POMBNK/DSpnp/ProgApp/ArduinoMega2560 Marlin update/система координат smd-раскладчика.jpg

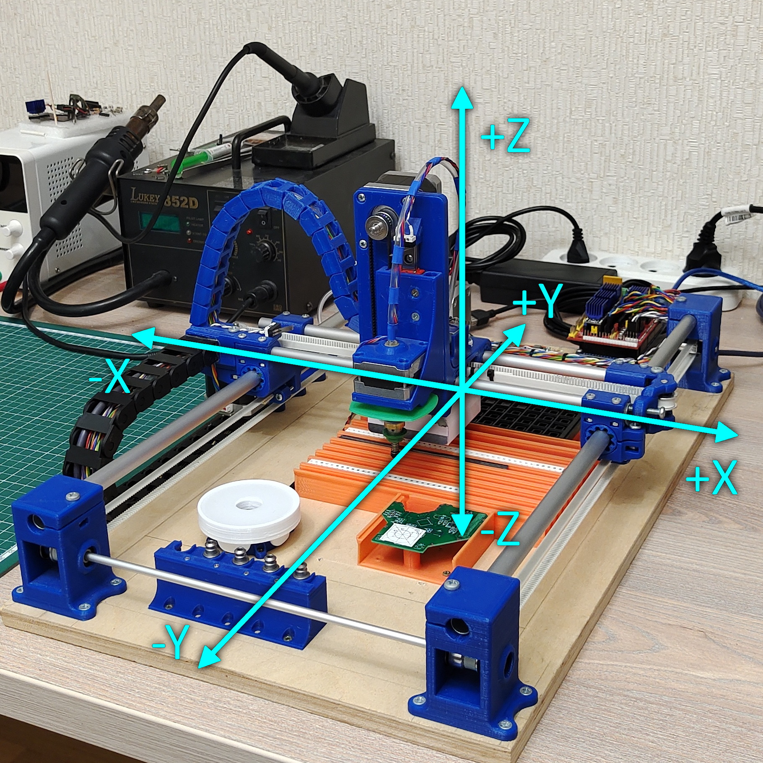
ProgApp/ArduinoMega2560 Marlin update/система координат smd-раскладчика.jpg
