POMBNK/DSpnp/README.md

TODO LIST:

- [X] 3D модель палетты
- [X] рассмотреть структуру python скриптов для OpenPnp
- [ ] 3D модель самой конструкции (см.SMD если ок,берем ее за основу)
