POMBNK/DSpnp/ProgApp/ArduinoMega2560 Marlin update/ramps.png

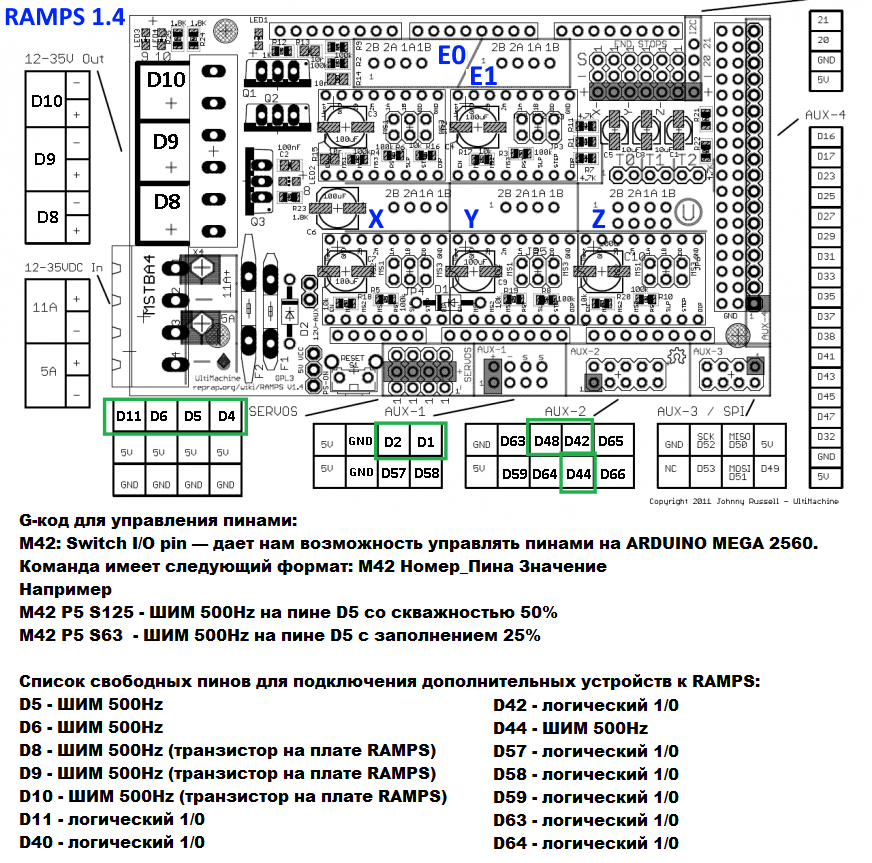
ProgApp/ArduinoMega2560 Marlin update/ramps.png
