POMBNK/DSpnp/ProgApp/OpenPnp settings/калибровка OpenPNP.pdf

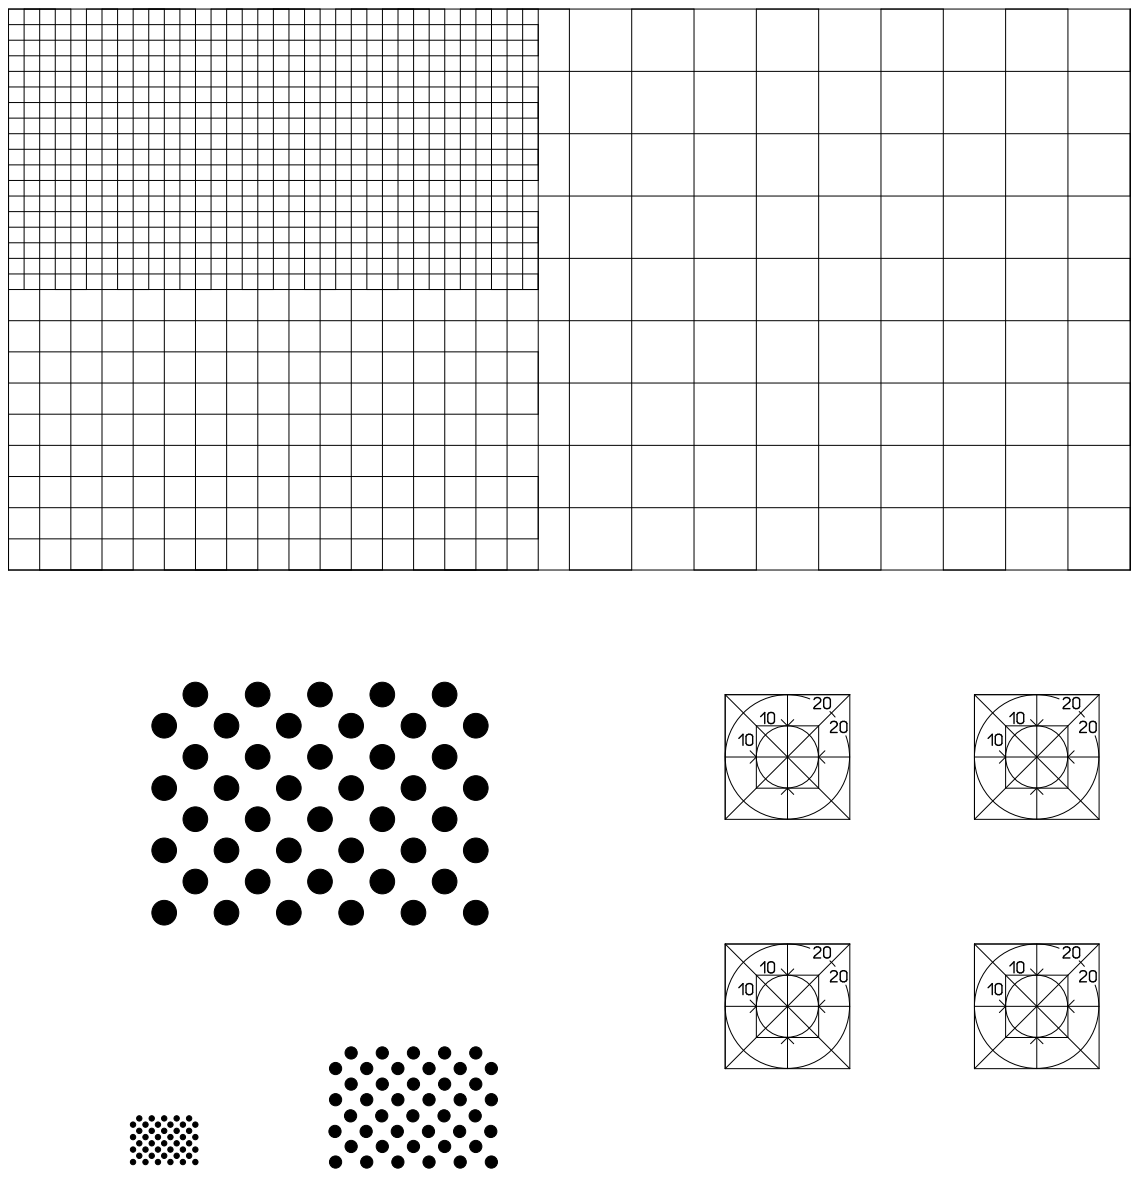
[picture p44: page 1]
