POMBNK/DSpnp/3D parts/smd-растановщик STL/голова (каретка с осью Z)/вспомогательный крепёж для верхней камеры.STL

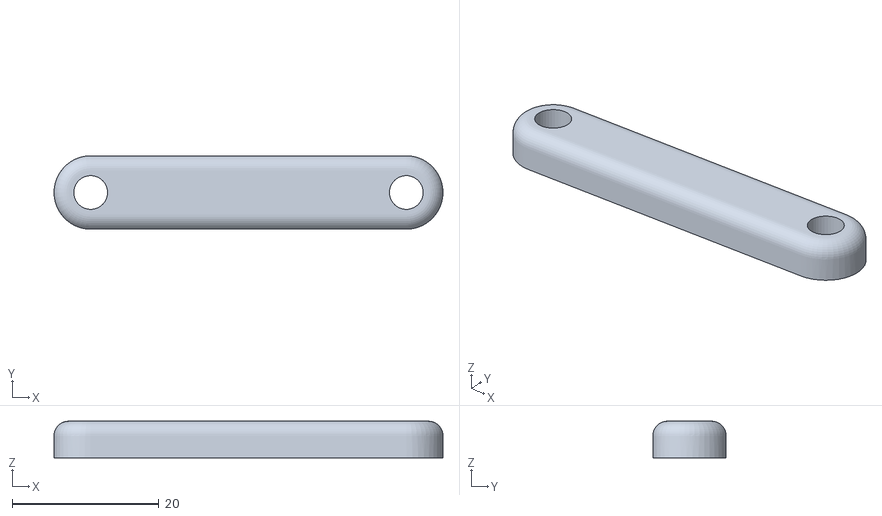
[picture p3: CAD file, 2022-07-06]
3D parts/smd-растановщик STL/голова (каретка с осью Z)/вспомогательный крепёж для верхней камеры.STL
53.0 x 10.0 x 5.00
