POMBNK/DSpnp/3D parts/smd-растановщик STL/держатель насадок/держатель насадок (нижняя деталь).STL

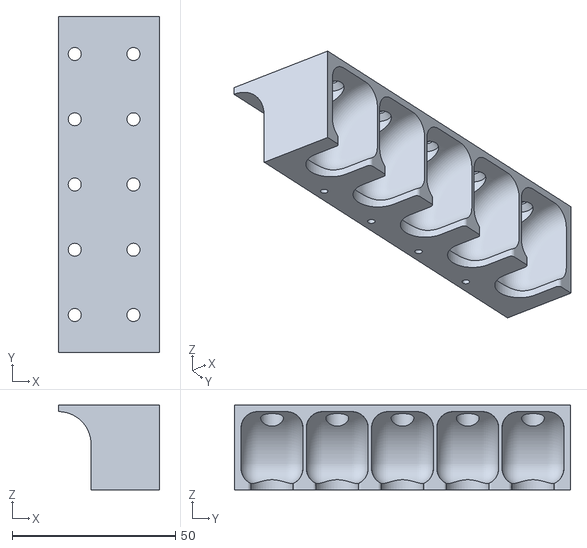
[picture p4: CAD file, 2022-07-06]
3D parts/smd-растановщик STL/держатель насадок/держатель насадок (нижняя деталь).STL
31.0 x 103.0 x 26.0
