POMBNK/DSpnp/3D parts/smd-растановщик STL/компрессор/держатель компрессора (вариант 1 на рабочее поле на резинках).STL

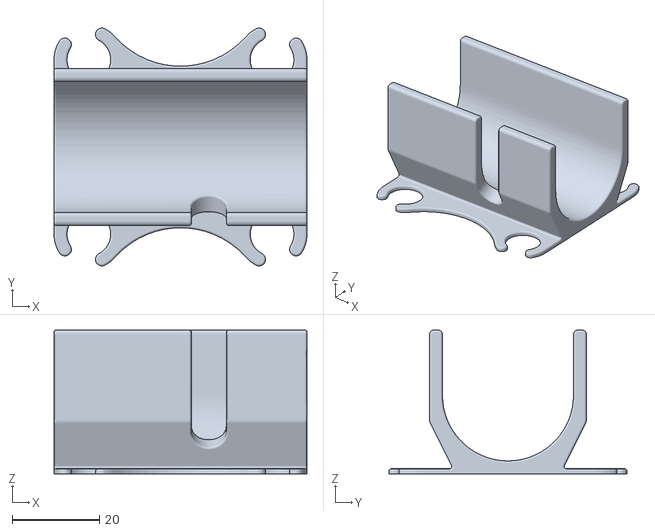
[picture p5: CAD file, 2022-07-06]
3D parts/smd-растановщик STL/компрессор/держатель компрессора (вариант 1 на рабочее поле на резинках).STL
58.0 x 54.5 x 33.0
