POMBNK/DSpnp/3D parts/smd-растановщик STL/нижнее зрение/крепёж нижней камеры.STL

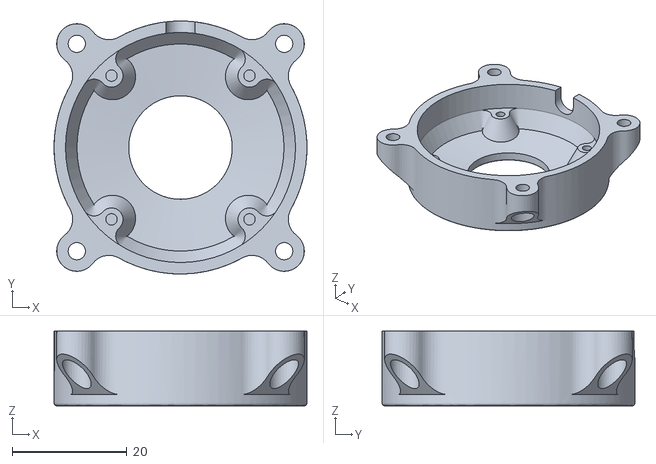
[picture p6: CAD file, 2022-07-06]
3D parts/smd-растановщик STL/нижнее зрение/крепёж нижней камеры.STL
44.0 x 44.0 x 13.0
