POMBNK/DSpnp/3D parts/smd-растановщик STL/ось E (поворот детали)/воздушная муфта оси Е из капельницы.STL

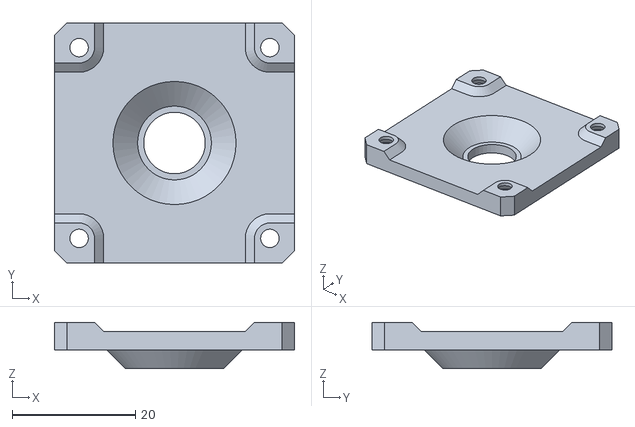
[picture p7: CAD file, 2022-07-06]
3D parts/smd-растановщик STL/ось E (поворот детали)/воздушная муфта оси Е из капельницы.STL
39.0 x 39.0 x 7.50
