POMBNK/DSpnp/3D parts/smd-растановщик STL/рабочие блоки осей X и Y/ось Y печатный подшипник 12.STL

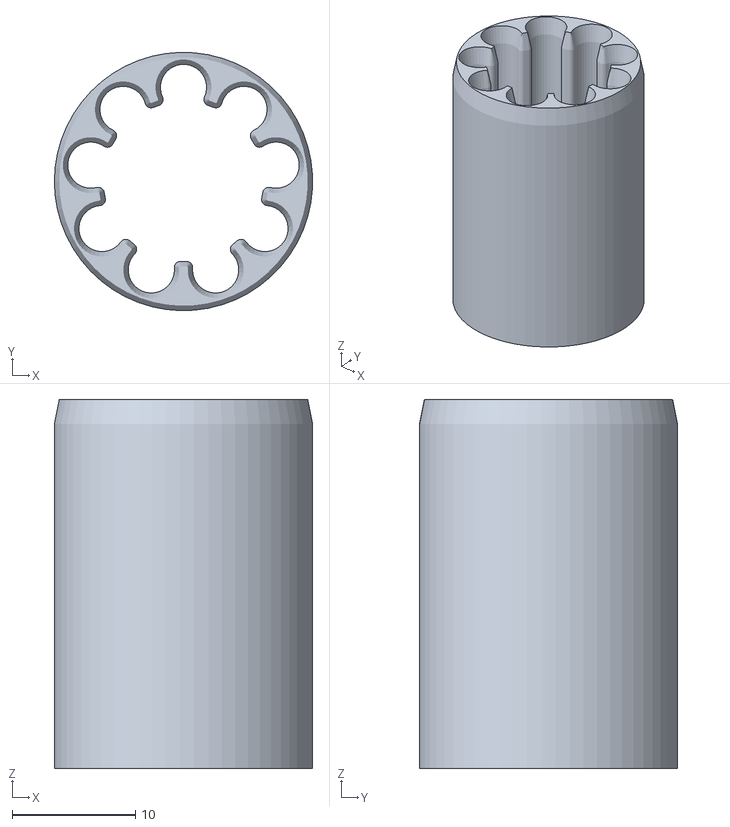
[picture p8: CAD file, 2022-07-06]
3D parts/smd-растановщик STL/рабочие блоки осей X и Y/ось Y печатный подшипник 12.STL
21.0 x 21.0 x 30.0
