POMBNK/DSpnp/3D parts/smd-растановщик STL/фидеры/sFeeder_16mm_8ganged.stl

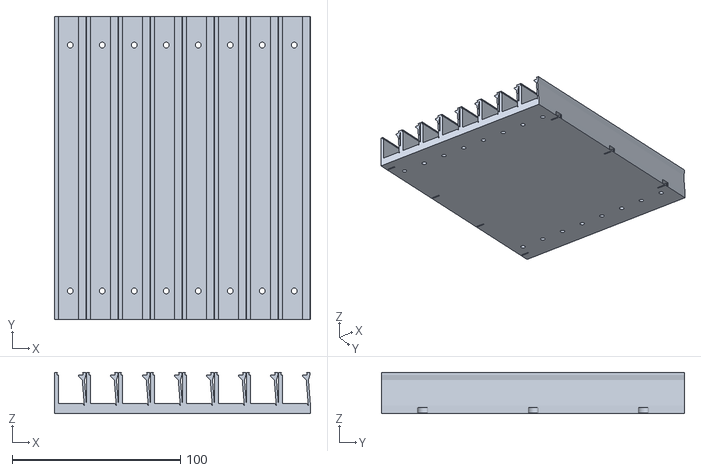
[picture p9: CAD file, 2022-07-06]
3D parts/smd-растановщик STL/фидеры/sFeeder_16mm_8ganged.stl
152.0 x 180.0 x 24.4
