POMBNK/DSpnp/3D parts/smd-растановщик STL/голова (каретка с осью Z)/звено кабель-канала.STL

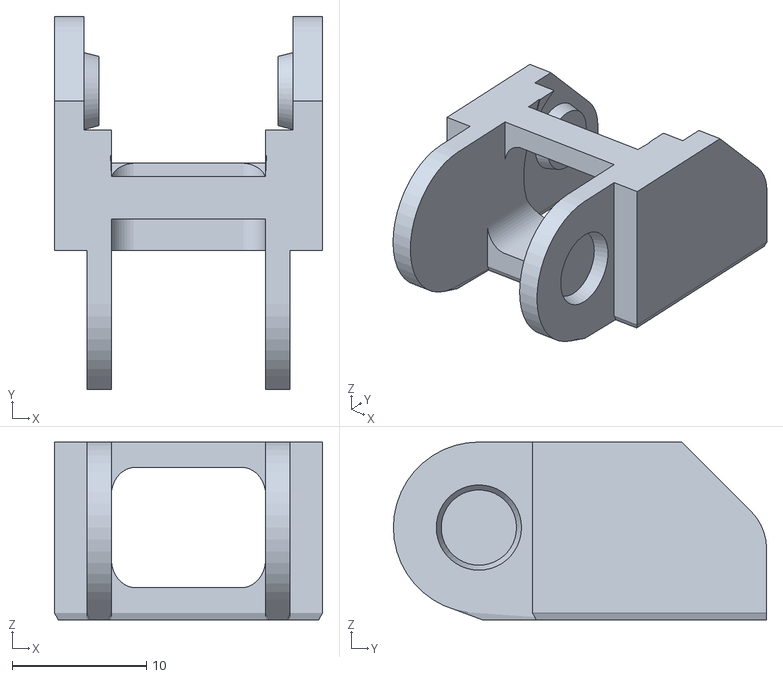
[picture p10: CAD file, 2022-07-06]
3D parts/smd-растановщик STL/голова (каретка с осью Z)/звено кабель-канала.STL
20.0 x 27.9 x 13.3
