POMBNK/DSpnp/3D parts/smd-растановщик STL/держатель насадок/дрежатель насадок (верхняя деталь).STL

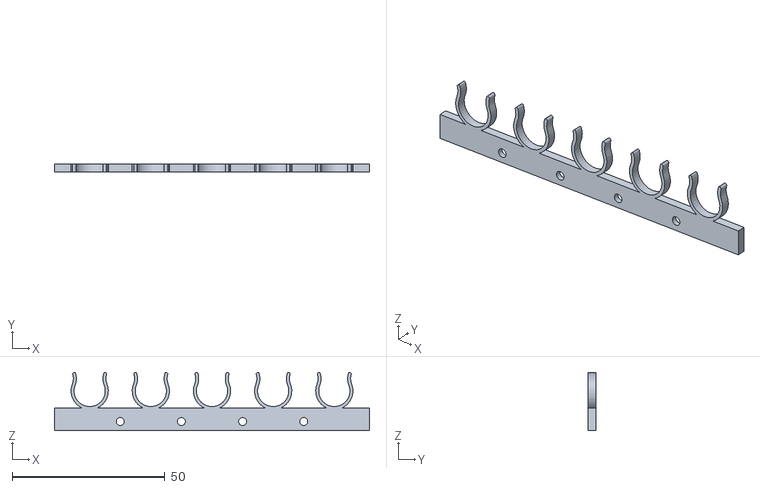
[picture p11: CAD file, 2022-07-06]
3D parts/smd-растановщик STL/держатель насадок/дрежатель насадок (верхняя деталь).STL
103.0 x 2.50 x 19.1
