POMBNK/DSpnp/3D parts/smd-растановщик STL/компрессор/держатель компрессора (вариант 2 на блоке с мотором оси Y).STL

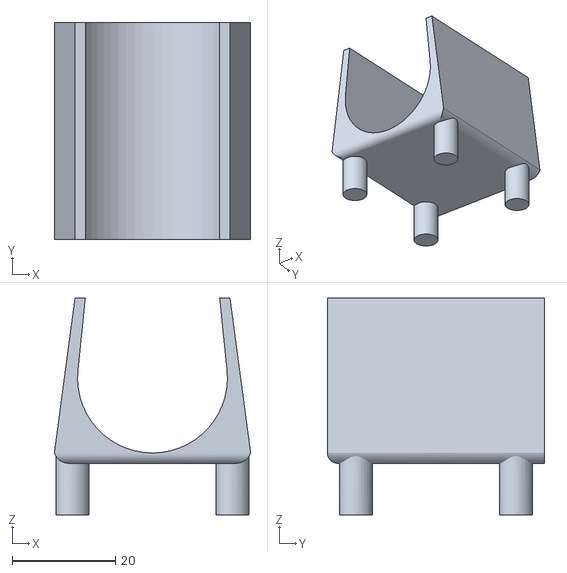
[picture p12: CAD file, 2022-07-06]
3D parts/smd-растановщик STL/компрессор/держатель компрессора (вариант 2 на блоке с мотором оси Y).STL
38.0 x 42.0 x 42.0
