POMBNK/DSpnp/3D parts/smd-растановщик STL/нижнее зрение/крепёж подсветки нижней камеры.STL

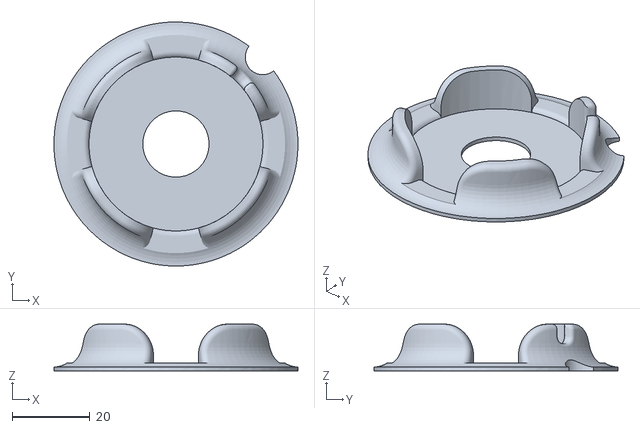
[picture p13: CAD file, 2022-07-06]
3D parts/smd-растановщик STL/нижнее зрение/крепёж подсветки нижней камеры.STL
62.6 x 62.6 x 12.0
