POMBNK/DSpnp/3D parts/smd-растановщик STL/ось E (поворот детали)/держатель мотора поворота деталей.STL

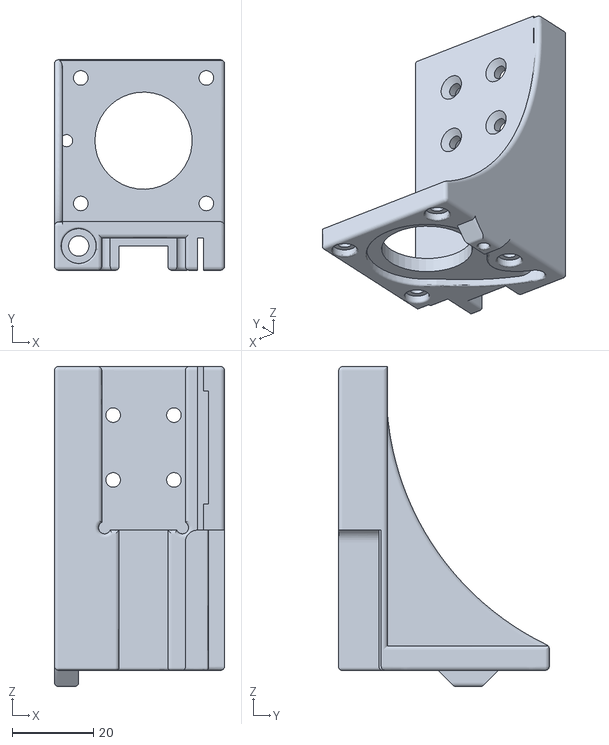
[picture p14: CAD file, 2022-07-06]
3D parts/smd-растановщик STL/ось E (поворот детали)/держатель мотора поворота деталей.STL
42.0 x 52.0 x 79.0
