POMBNK/DSpnp/3D parts/smd-растановщик STL/рабочие блоки осей X и Y/ось X блок с мотором.STL

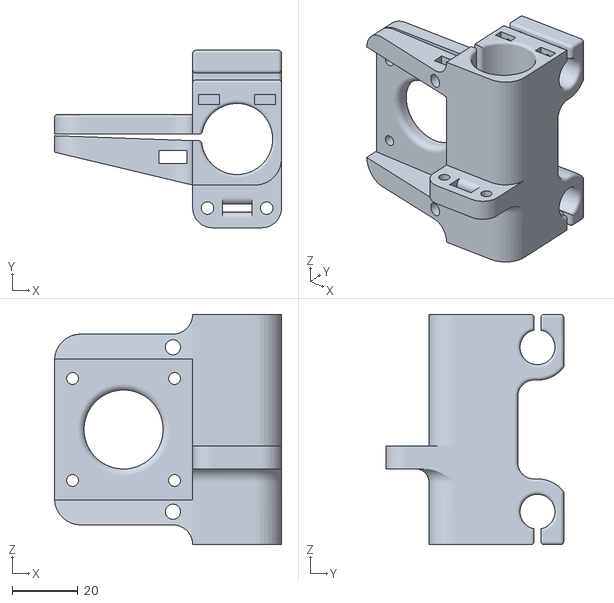
[picture p15: CAD file, 2022-07-06]
3D parts/smd-растановщик STL/рабочие блоки осей X и Y/ось X блок с мотором.STL
69.0 x 54.0 x 70.0
