POMBNK/DSpnp/3D parts/smd-растановщик STL/фидеры/sFeeder_8mm_8ganged.stl

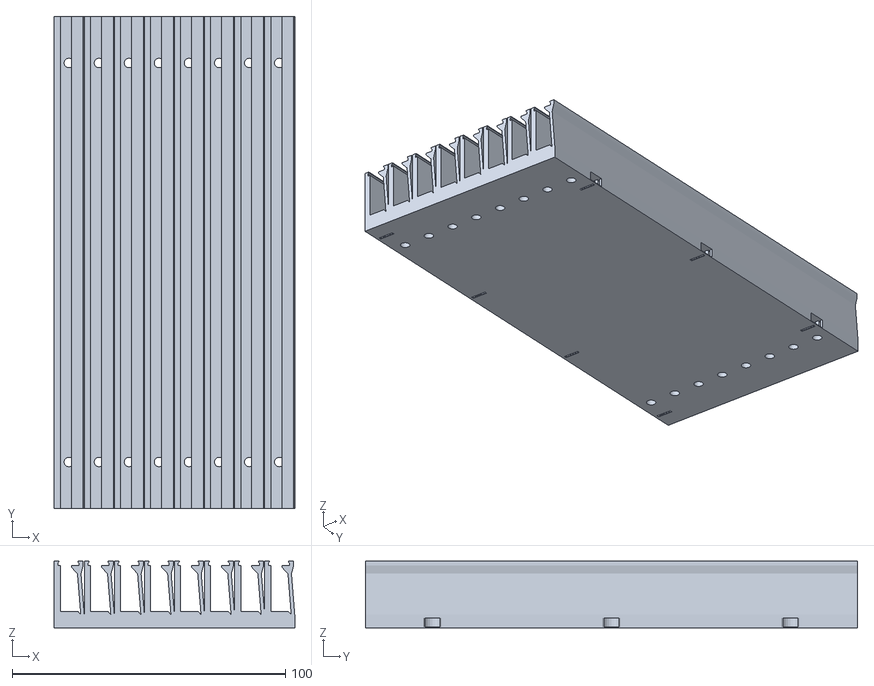
[picture p16: CAD file, 2022-07-06]
3D parts/smd-растановщик STL/фидеры/sFeeder_8mm_8ganged.stl
88.0 x 180.0 x 24.4
