POMBNK/DSpnp/3D parts/smd-растановщик STL/голова (каретка с осью Z)/верхняя камера маленькая (салазки крепятся на клей к каретке).STL

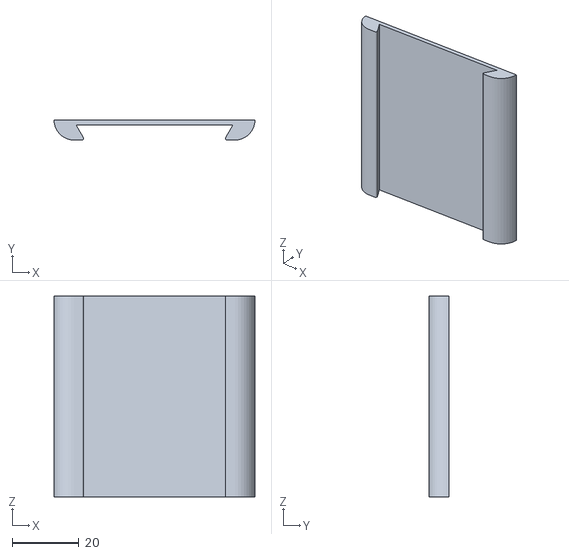
[picture p17: CAD file, 2022-07-06]
3D parts/smd-растановщик STL/голова (каретка с осью Z)/верхняя камера маленькая (салазки крепятся на клей к каретке).STL
60.0 x 6.00 x 60.0
