POMBNK/DSpnp/3D parts/smd-растановщик STL/держатель насадок/держатель насадок (средняя деталь).STL

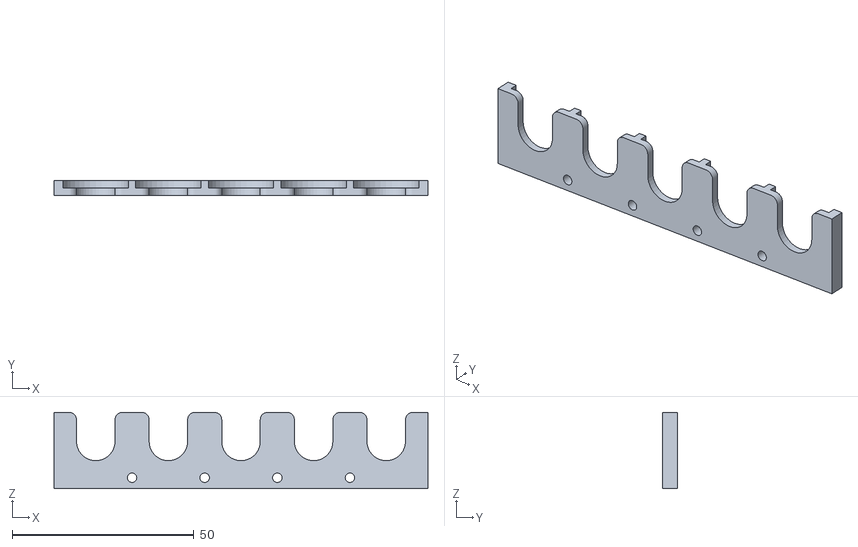
[picture p18: CAD file, 2022-07-06]
3D parts/smd-растановщик STL/держатель насадок/держатель насадок (средняя деталь).STL
103.0 x 4.00 x 21.0
