POMBNK/DSpnp/3D parts/smd-растановщик STL/нижнее зрение/рассеиватель подсветки нижней камеры.STL

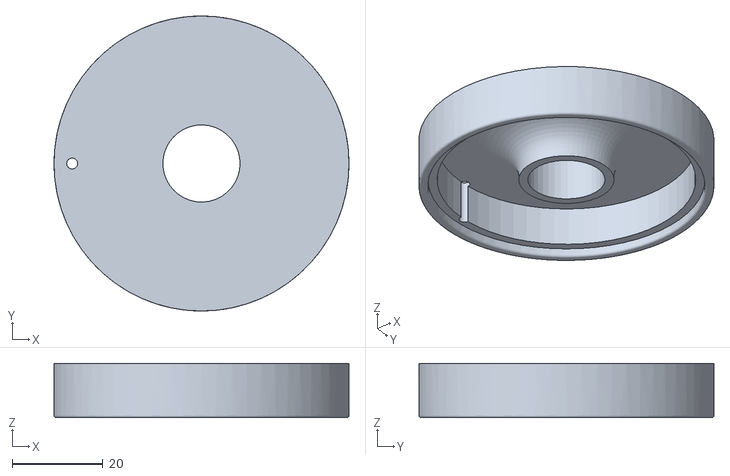
[picture p19: CAD file, 2022-07-06]
3D parts/smd-растановщик STL/нижнее зрение/рассеиватель подсветки нижней камеры.STL
65.0 x 65.0 x 12.0
