POMBNK/DSpnp/3D parts/smd-растановщик STL/ось E (поворот детали)/фон для деталей (печатать зелёным пластиком).STL

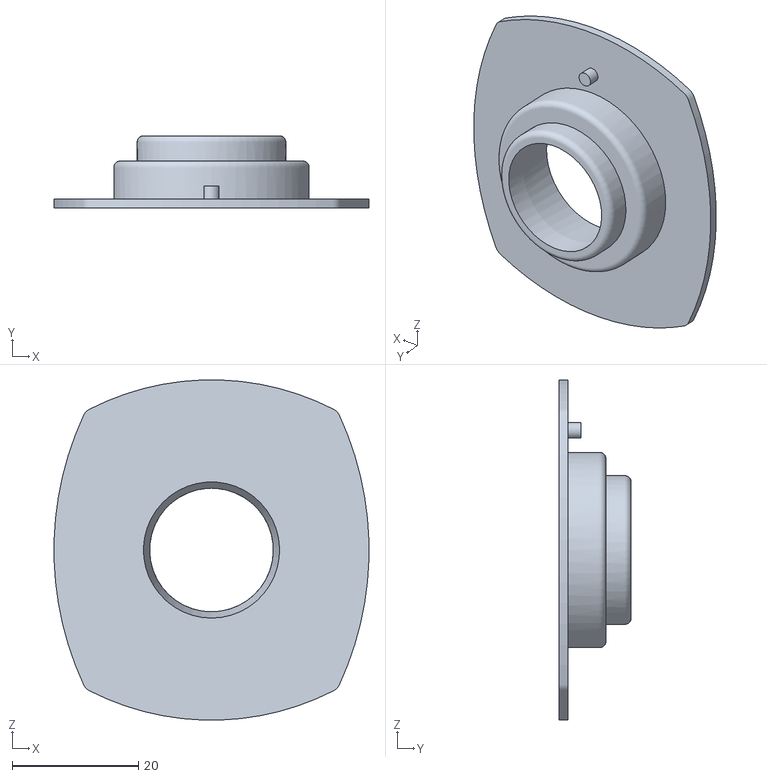
[picture p20: CAD file, 2022-07-06]
3D parts/smd-растановщик STL/ось E (поворот детали)/фон для деталей (печатать зелёным пластиком).STL
49.9 x 11.5 x 53.9
