POMBNK/DSpnp/3D parts/smd-растановщик STL/фидеры/sFeeder_12mm_4ganged.stl

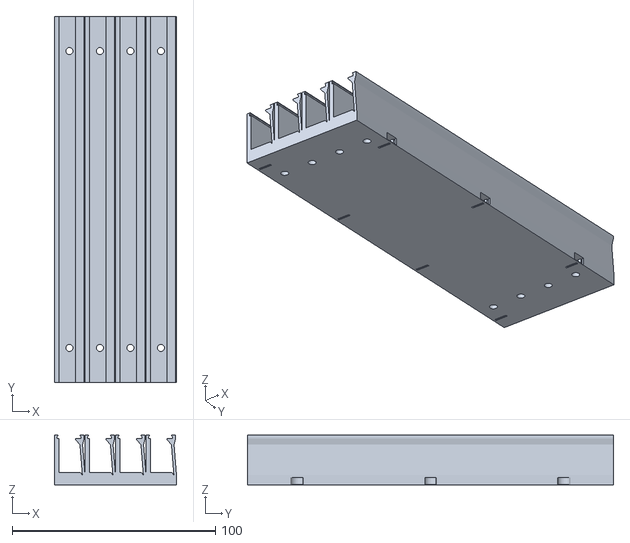
[picture p22: CAD file, 2022-07-06]
3D parts/smd-растановщик STL/фидеры/sFeeder_12mm_4ganged.stl
60.0 x 180.0 x 24.4
