POMBNK/DSpnp/3D parts/smd-растановщик STL/голова (каретка с осью Z)/каретка (держатель оси Z).STL

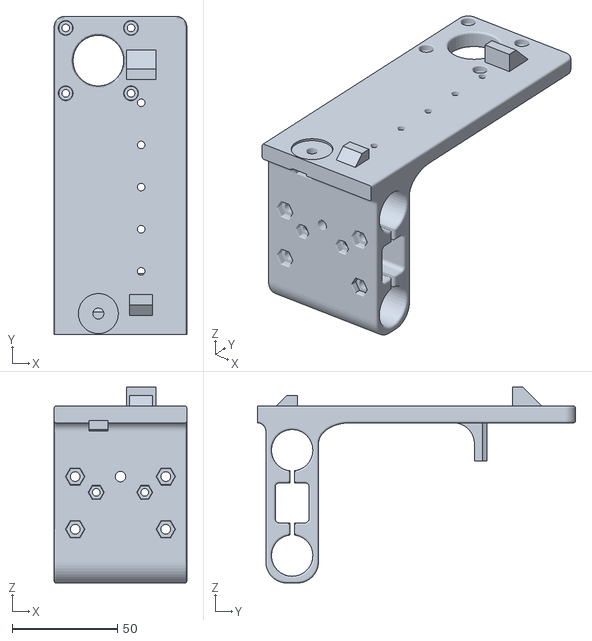
[picture p23: CAD file, 2022-07-06]
3D parts/smd-растановщик STL/голова (каретка с осью Z)/каретка (держатель оси Z).STL
63.0 x 151.0 x 93.0
