POMBNK/DSpnp/3D parts/smd-растановщик STL/рабочие блоки осей X и Y/ось Х натяжитель.STL

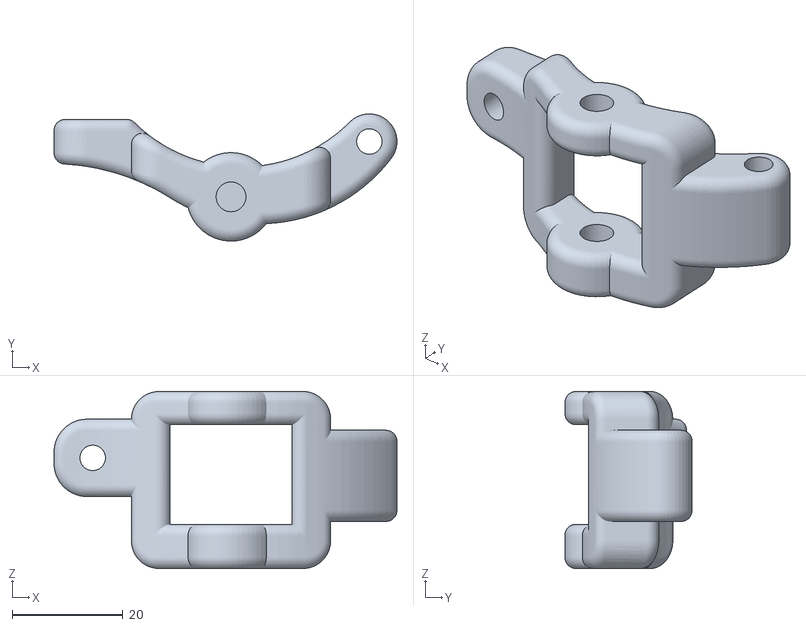
[picture p24: CAD file, 2022-07-06]
3D parts/smd-растановщик STL/рабочие блоки осей X и Y/ось Х натяжитель.STL
62.0 x 23.0 x 32.0
