POMBNK/DSpnp/3D parts/smd-растановщик STL/голова (каретка с осью Z)/верхняя камера большая (вариант 2).STL

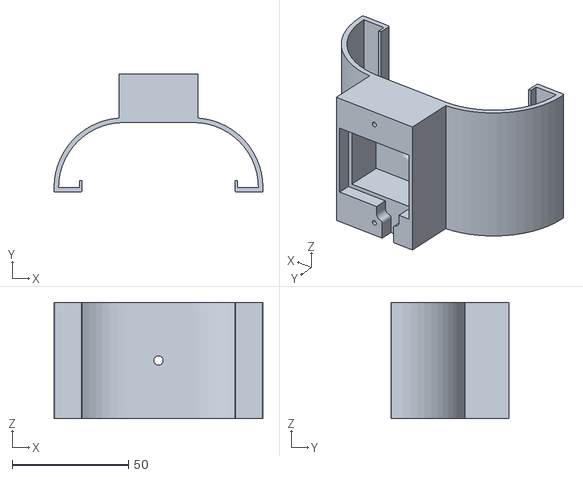
[picture p26: CAD file, 2022-07-06]
3D parts/smd-растановщик STL/голова (каретка с осью Z)/верхняя камера большая (вариант 2).STL
90.0 x 51.0 x 50.0
