POMBNK/DSpnp/3D parts/smd-растановщик STL/рабочие блоки осей X и Y/ось X держатель кабель-канала.STL

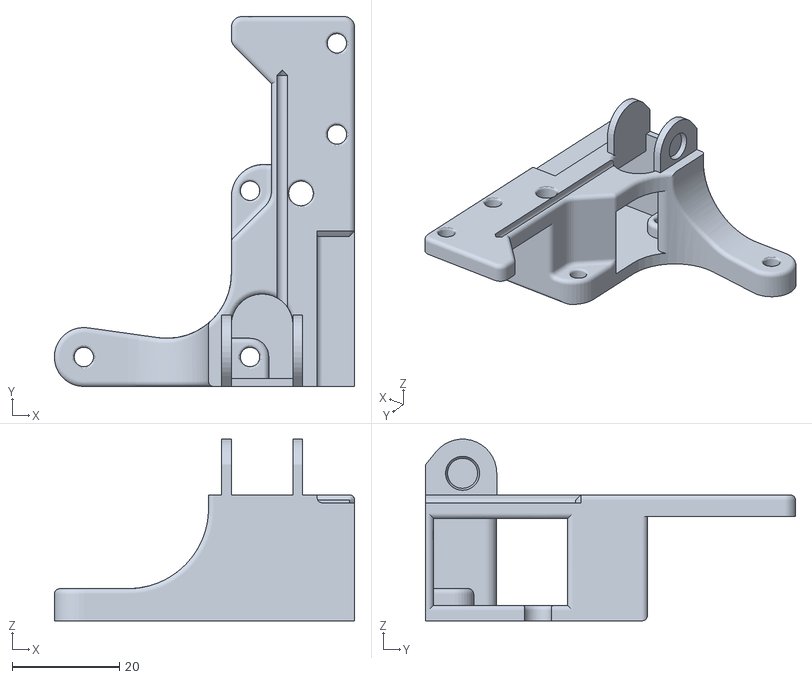
[picture p27: CAD file, 2022-07-06]
3D parts/smd-растановщик STL/рабочие блоки осей X и Y/ось X держатель кабель-канала.STL
56.0 x 69.0 x 33.9
