POMBNK/DSpnp/3D parts/smd-растановщик STL/фидеры/sFeeder_8mm_4ganged.stl

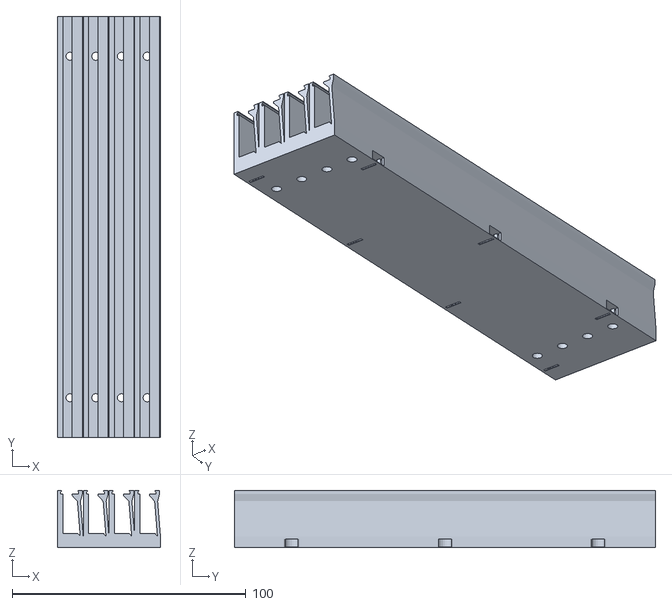
[picture p28: CAD file, 2022-07-06]
3D parts/smd-растановщик STL/фидеры/sFeeder_8mm_4ganged.stl
44.0 x 180.0 x 24.4
