POMBNK/DSpnp/3D parts/smd-растановщик STL/голова (каретка с осью Z)/верхняя камера маленькая (для камер от ноутбука).STL

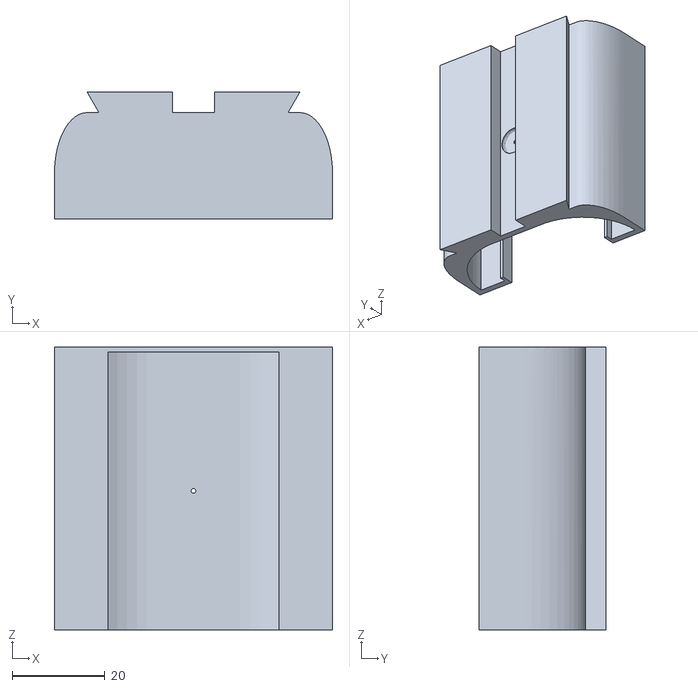
[picture p29: CAD file, 2022-07-06]
3D parts/smd-растановщик STL/голова (каретка с осью Z)/верхняя камера маленькая (для камер от ноутбука).STL
60.0 x 27.5 x 61.0
