POMBNK/DSpnp/3D parts/smd-растановщик STL/рабочие блоки осей X и Y/ось X печатный подшипник 10.STL

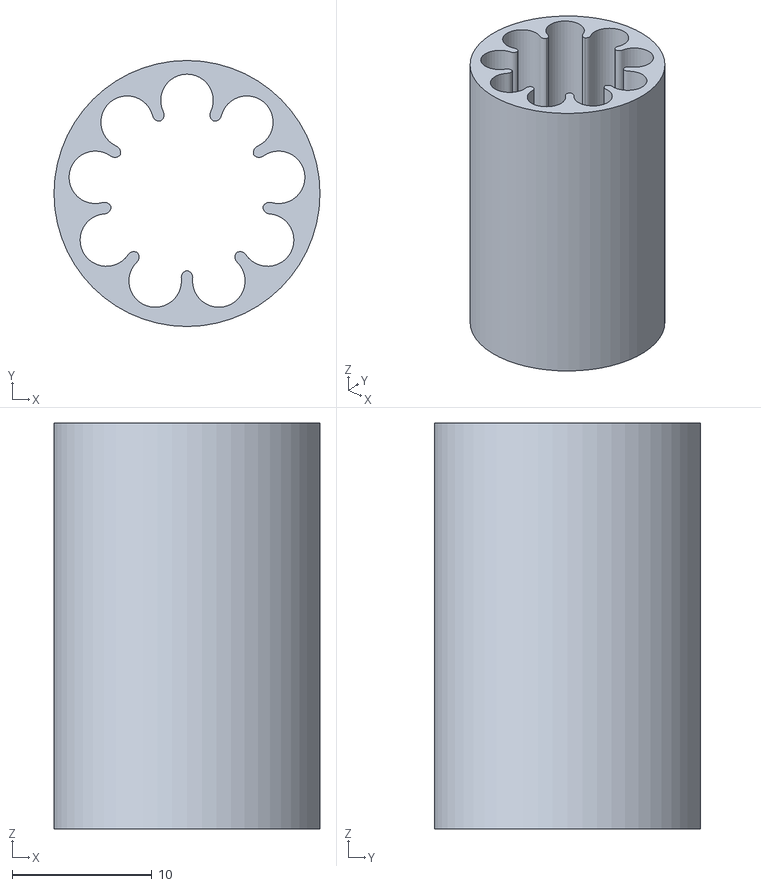
[picture p30: CAD file, 2022-07-06]
3D parts/smd-растановщик STL/рабочие блоки осей X и Y/ось X печатный подшипник 10.STL
19.0 x 19.0 x 29.0
