POMBNK/DSpnp/3D parts/smd-растановщик STL/голова (каретка с осью Z)/держатель кабель-канала и воздушного клапана.STL

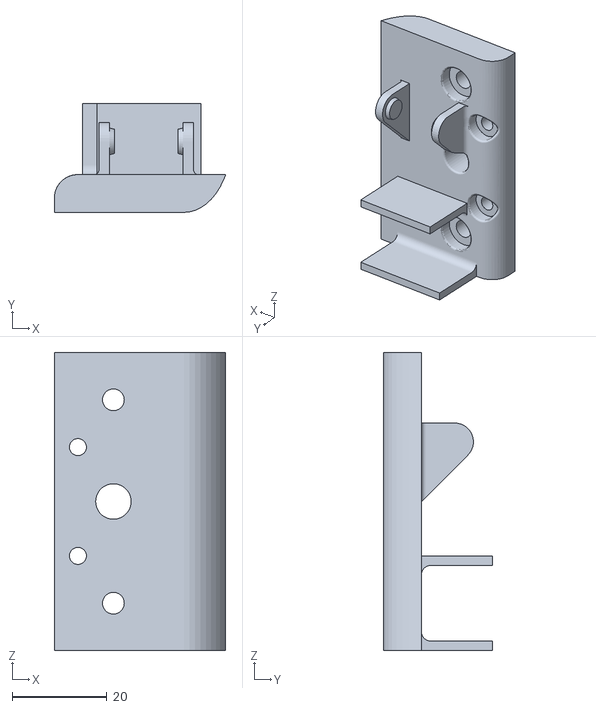
[picture p32: CAD file, 2022-07-06]
3D parts/smd-растановщик STL/голова (каретка с осью Z)/держатель кабель-канала и воздушного клапана.STL
36.2 x 23.0 x 63.0
