POMBNK/DSpnp/3D parts/smd-растановщик STL/рабочие блоки осей X и Y/ось Y натяжитель.STL

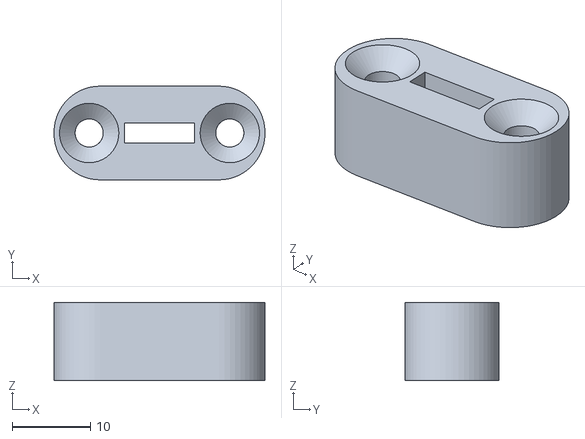
[picture p33: CAD file, 2022-07-06]
3D parts/smd-растановщик STL/рабочие блоки осей X и Y/ось Y натяжитель.STL
27.0 x 12.0 x 10.0
