POMBNK/DSpnp/3D parts/smd-растановщик STL/голова (каретка с осью Z)/верхняя камера большая (вариант 1).STL

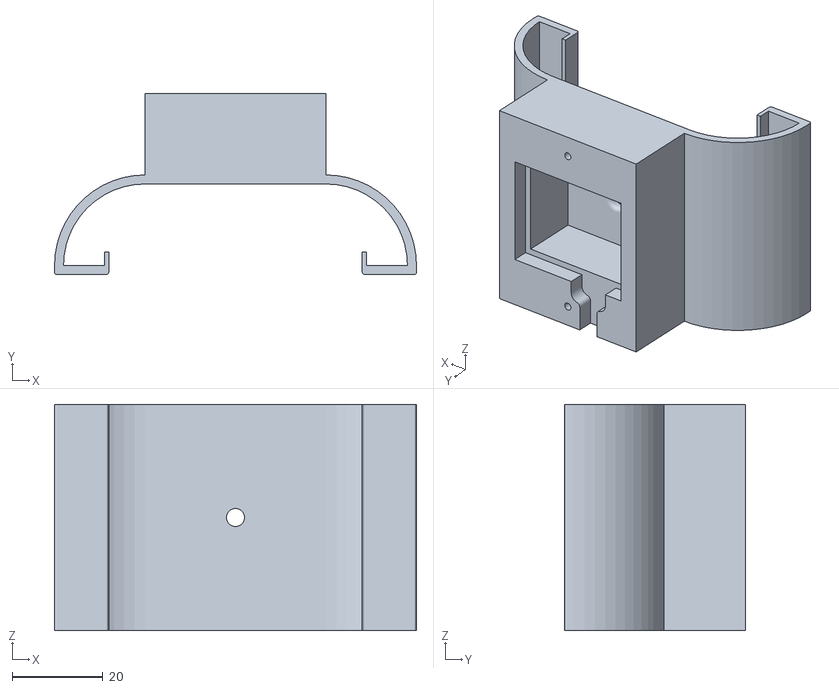
[picture p34: CAD file, 2022-07-06]
3D parts/smd-растановщик STL/голова (каретка с осью Z)/верхняя камера большая (вариант 1).STL
80.0 x 40.0 x 50.0
