POMBNK/DSpnp/3D parts/smd-растановщик STL/рабочие блоки осей X и Y/втулка на вал 5мм (для центровки зубчатых шкивов в блоках оси Y).STL

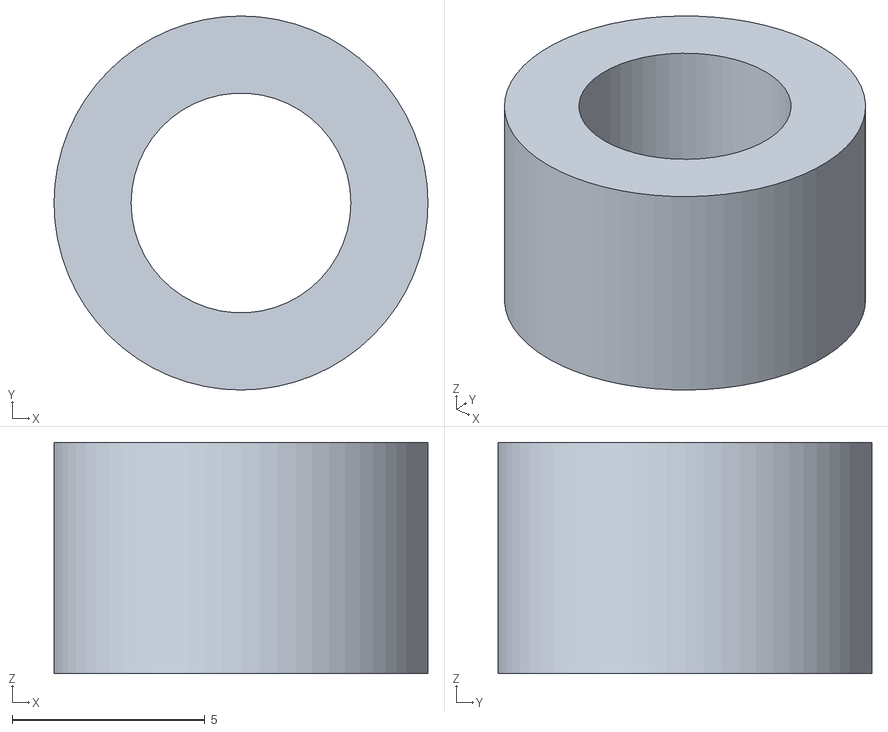
[picture p35: CAD file, 2022-07-06]
3D parts/smd-растановщик STL/рабочие блоки осей X и Y/втулка на вал 5мм (для центровки зубчатых шкивов в блоках оси Y).STL
9.70 x 9.70 x 6.00
