POMBNK/DSpnp/3D parts/smd-растановщик STL/фидеры/sFeeder_8mm_2ganged.stl

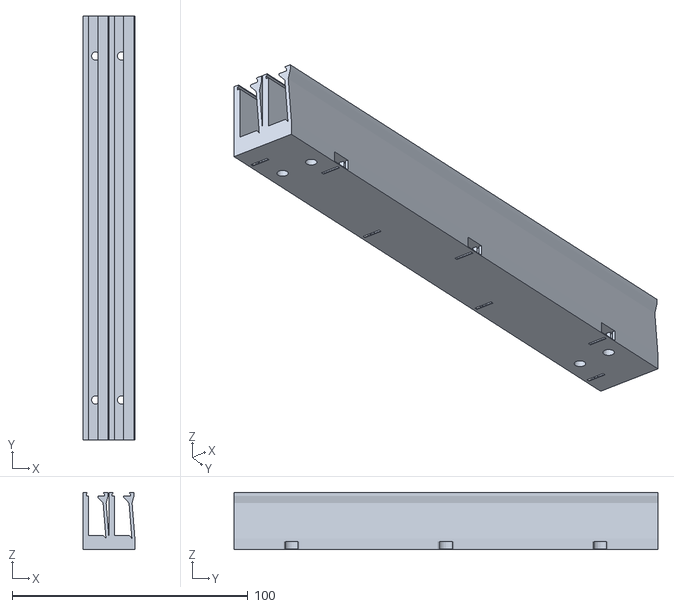
[picture p36: CAD file, 2022-07-06]
3D parts/smd-растановщик STL/фидеры/sFeeder_8mm_2ganged.stl
22.0 x 180.0 x 24.4
