POMBNK/DSpnp/3D parts/smd-растановщик STL/рабочие блоки осей X и Y/ось Y блок с мотором.STL

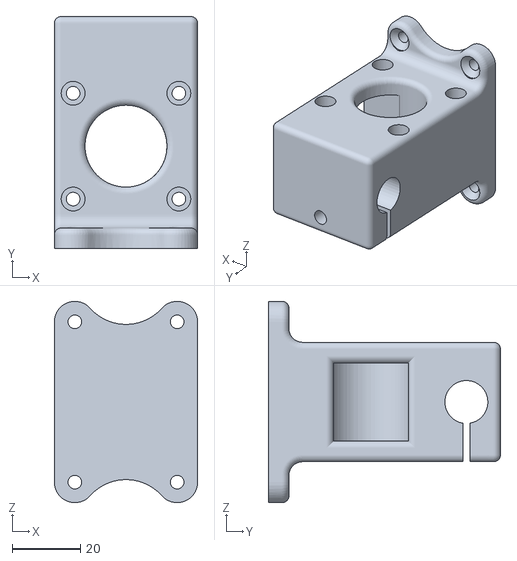
[picture p37: CAD file, 2022-07-06]
3D parts/smd-растановщик STL/рабочие блоки осей X и Y/ось Y блок с мотором.STL
42.0 x 68.0 x 59.0
