POMBNK/DSpnp/3D parts/smd-растановщик STL/фидеры/sFeeder_16mm_2ganged.stl

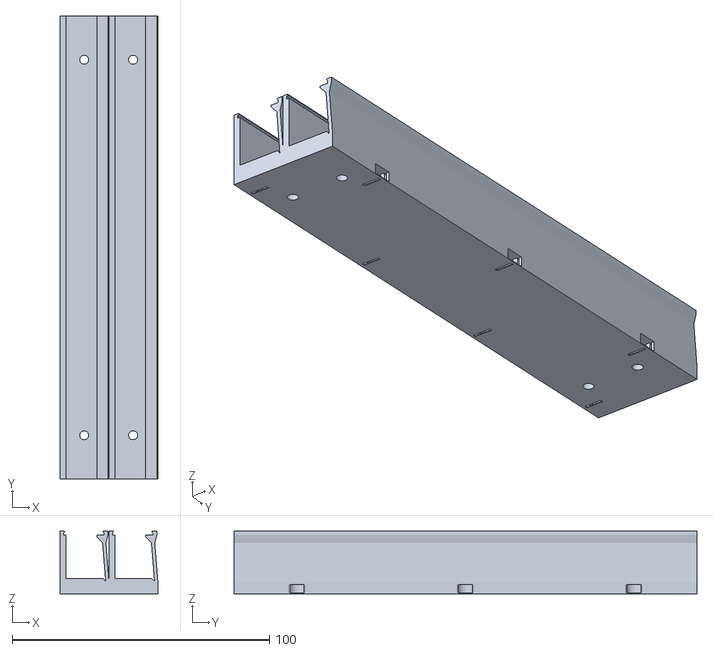
[picture p38: CAD file, 2022-07-06]
3D parts/smd-растановщик STL/фидеры/sFeeder_16mm_2ganged.stl
38.0 x 180.0 x 24.4
