POMBNK/DSpnp/3D parts/smd-растановщик STL/рабочие блоки осей X и Y/ось X блок с натяжителем.STL

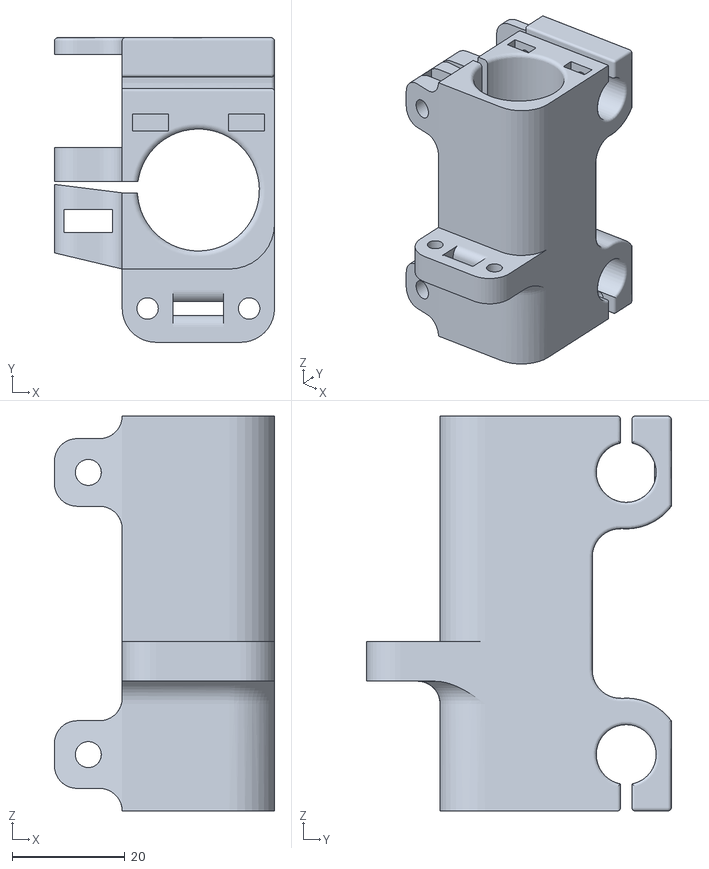
[picture p39: CAD file, 2022-07-06]
3D parts/smd-растановщик STL/рабочие блоки осей X и Y/ось X блок с натяжителем.STL
39.0 x 54.0 x 70.0
