POMBNK/DSpnp/3D parts/smd-растановщик STL/фидеры/sFeeder_12mm_8ganged.stl

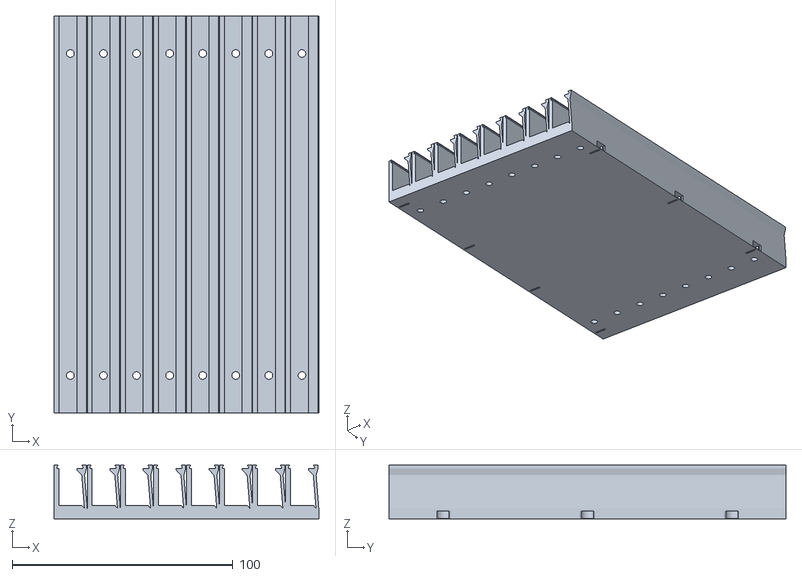
[picture p40: CAD file, 2022-07-06]
3D parts/smd-растановщик STL/фидеры/sFeeder_12mm_8ganged.stl
120.0 x 180.0 x 24.4
