POMBNK/DSpnp/3D parts/smd-растановщик STL/фидеры/sFeeder_16mm_4ganged.stl

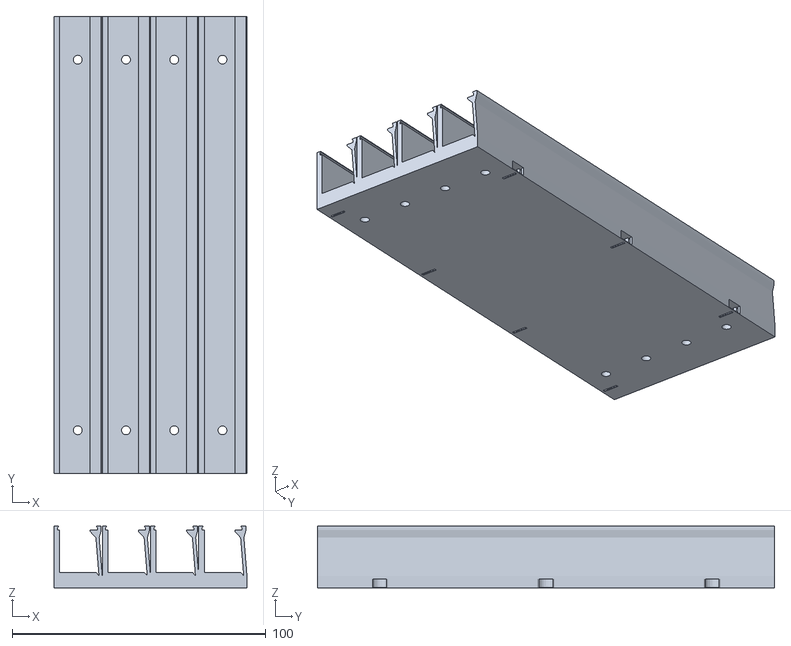
[picture p41: CAD file, 2022-07-06]
3D parts/smd-растановщик STL/фидеры/sFeeder_16mm_4ganged.stl
76.0 x 180.0 x 24.4
