POMBNK/DSpnp/3D parts/smd-растановщик STL/фидеры/sFeeder_16mm_6ganged.stl

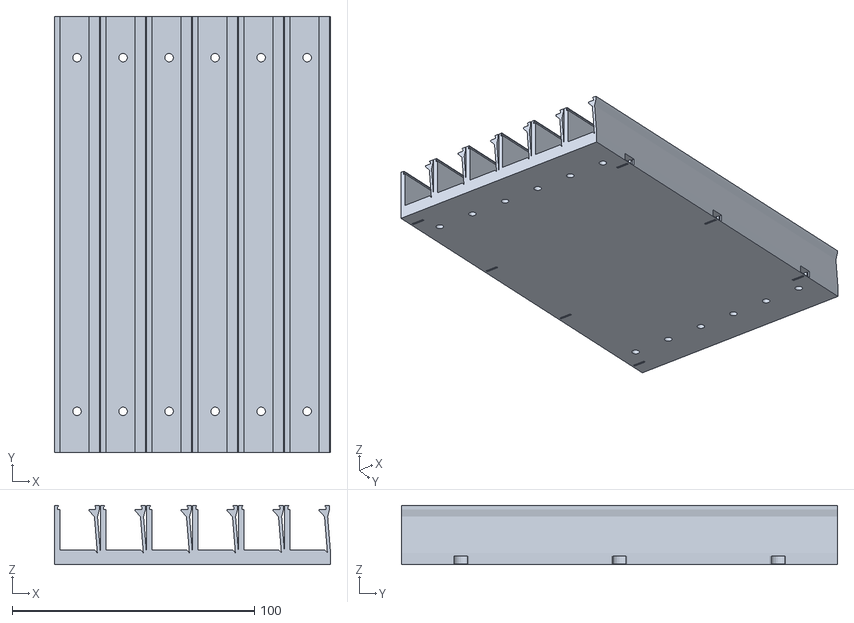
[picture p42: CAD file, 2022-07-06]
3D parts/smd-растановщик STL/фидеры/sFeeder_16mm_6ganged.stl
114.0 x 180.0 x 24.4
