POMBNK/DSpnp/3D parts/smd-растановщик STL/фидеры/sFeeder_12mm_6ganged.stl

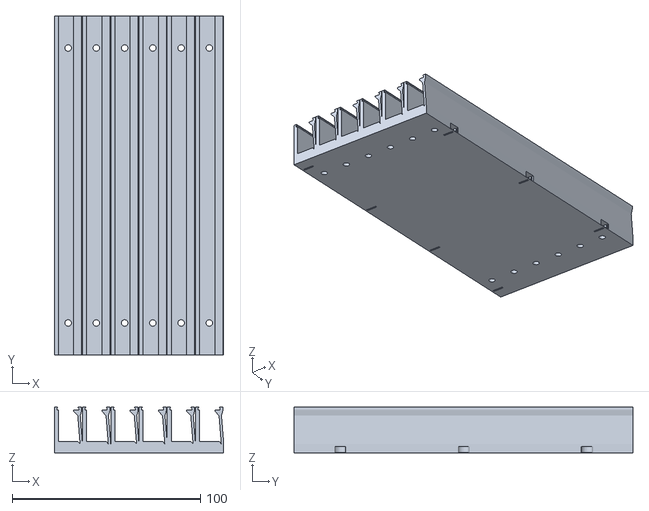
[picture p43: CAD file, 2022-07-06]
3D parts/smd-растановщик STL/фидеры/sFeeder_12mm_6ganged.stl
90.0 x 180.0 x 24.4
