POMBNK/DSpnp/(list of files, cad)

Other CAD files:
3D parts/smd-растановщик STL/фидеры/sFeeder_8mm_8ganged_1bankID.stl
